cubanismo/skunk_pcb/(commit log)

2020-09-12 Check in skunkboard rev. 3 FeePCB project
    This is a direct copy of:
    FULL_RELEASE/sources/pcb3/pcb/jagwave/revision3.fpc
    renamed to skunkboard.fpc
    NOTE: Doesn't work if converted to Unix-style line
    endings!
2020-09-12 Check in skunkboard component library
    This is copied directly from:
    FULL_RELEASE/sources/pcb3/freepcb/lib_extra
2020-09-26 Rev5 checkpoint: Rerouting completed, U5+U6 placed
    -Rerouted various traces that were getting in the
    way of GPIO25 and GPIO28.
    -Clear a path to route GPIO25 and GPIO28 to the
    right edge of the board, precarious as it may be.
    -Place U5 and U6 SOIC-8 Serial EEPROM components
    -NOTE: Not connected to any nets yet.
    -Moved X1 a bit lower to make space for GPIO
    routing.
    -Tweaked J0.A54/J0.A53 trace to move its via out
    of the way of the inner-layer traces that will
    route the Serial EEPROM control lines from the
    cartridge header, as was done on Rev4.
2020-09-26 Rev5 checkpoint: Extended GND+VCC plane to right
    -Raised up bottom of GND+VCC plane on the long
    portion of the edge connector to make room for
    Serial Flash control line routes in inner layers.
    -Nudged edge of ground plane to the left at the
    ridge edge of the edge connector to make room for
    the same routes.
2020-09-26 Rev5 checkpoint: Add XSON8 footprint, add U7
    -Designed a footprint for XSON8 parts (The package
    used by the AND gate IC) based on the layouts
    recommended in the NXP document "AN10343 -
    MicroPak soldering information."
    -Placed U7 using the XSON8 footprint.
2020-09-26 Rev5 checkpoint: Routed most of Serial Flash
    All of the routing difficulties for the two Serial
    EEPROM chips have been solved now.
    -The perilous routes to the GPIO pins from the AND
    gate appear to fit!
    -The shared data and clock lines on the Serial
    EEPROM chips have been linked using vias.
    There are still some tough problems to solve.
    There is not going to be quite enough room to
    squeeze the last signals into the AND gate chip
    as-is, and routing the control lines from the
    edge connector in general is looking tricky.
2020-09-26 Rev5 checkpoint: All routing done!
    The control signals from the edge connector are
    all routed into the serial EEPROM chip and AND
    gate IC now. Only trivial tasks remain:
    -Update the silkscreen layers:
    -Add a bottom silk layer with the skunk logo and
    JTAG labels. These were very helpful during
    bringup.
    -Move version info to left side of board, update
    copyright to 2020, and don't forget to thank
    Tursi!
    -Enlarge the mini USB mounting pads to make them
    more secure.
2020-10-05 Update notes, more very minor routing tweaks
    -Leveled the Serial EEPROM trace in inner 2 layer
2020-10-05 Enlarge mini-USB/J3 mounting pads/update notes
    Similar to the Rev. 4 design, enlarge these pads
    to better anchor this heavily-used connector to
    the board.
    Also better documented the steps taken thus far to
    modify the PCB, as well as the wiring of the
    prototype on the Rev. 4 board.
2020-10-05 Finish top silkscreen layer
    -Added revision info on the left side
    -Replaced existing revision info with a thank you
    to Tursi
    -Added edge connector pin numbering on the bottom
2020-10-05 Restore 7.875mil/0.2mm trace width/clearances
    The readme.txt claims the design rule is 2mm/
    7.875mil for trace width and spacing. I had
    tweaked that to 7mil in frustration at some point,
    but it turns out it's possible to tweak a few
    things and restore the old higher requirements.
2020-10-05 Soldermask work: fix XSON8 footprint, adjust swell
    Did a bunch of research on soldermask limitations
    and what they mean for some of the fine pin-pitch
    parts used here. Basically, there's probably no
    reliable way to get soldermask between the finer
    parts. When generating some test gerber files, I
    remembered I naively set up a custom negative mask
    swell for the XSON8 footprint. I set the footprint
    to use the project default here. The project
    default was also a rather high 7.854mil (0.2mm),
    which was far more than is needed these days and
    was wiping out hte mask for the Serial EEPROM
    chip, so I lowered it to 6mil, which still removes
    all the slivers of mask between all the 0.2mm-
    spaced pads, a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
2020-10-05 First chunk of work on new logo/back silkscreen
    Figured out and documented (in skunk_v5.txt) a
    workflow for creating a gerber file from an
    Inkscape SVG file. Currently, back_silk.svg is a
    near-exact duplicate of the original back silk
    screen, but now that I've worked out the process,
    it will be trivial to make the minor updates I had
    in mind.
2020-10-05 Finish Silkscreen, update soldermask conclusions
    Made all the planned edits to the back silkscreen
    SVG file and documented the final plan for
    handling the soldermask for the fine pin pitch
    parts (manually exclude the ones with 0.2mm
    spacing, lower the soldermask pad swell to 0.3mm
    for the board overall).
    Also documented the inability of the carefully
    developed Cenon workflow to correctly convert the
    finalized back silkscreen SVG file to a gerber
    file :-(
2020-10-05 Hopefully final version of back silkscreen
    Moved the acknowledgements to the back silkscreen
    and tweaked a few things here and there.
2020-10-05 Rev. 5 PCB layout is now at RC status
    Added manual soldermask cutouts for all the parts
    with <0.3mm pad spacing and lowered the soldermask
    swell to improve coverage between pads on parts
    with spacing above that (We'll get soldermask
    between the mini USB connector pins!).
    Made a few very, very minor tweaks to a trace here
    and there.
    Removed harmlesslion.com and Tursi acknowledgement
    in favor of thanking various people on the back
    and letting the github link stand alone. I can
    always link back to harmlesslion.com or Tursi's
    skunk-related repos there.
2020-10-05 Check in Rev. 5 RC1 files
    -Added mkfab.sh, which converts the gerber files
    output by FreePCB and the crazy back silkscreen
    generation workflow into a zip file suitable for
    sending to manufacturers. It's still incomplete,
    as it should have a readme.txt packaged in there
    as well (mostly for historical benefit,
    manufacturers will likely ignore it), and OSH
    Park recommends a different file layout that
    should be supported as well via a command line
    option, but it's a start.
    -Updated pre-release checklist items based on
    initial inspection in gerber viewer
    -Checked in the RC1 manufacturing files.
2020-10-05 Updated Rev. 5 Notes: More design review completed
    Also documented a failed attempt at using FAB 3000
    to generate the bottom silkscreen layer.
2020-10-05 Finalize Rev. 5 RC1 - It's off to manufacturing!
    -Add Osh Park naming scheme support (also much
    closer to that supported by GerbView) to
    mkfab.sh. Use the '--osh' command line parameter
    to choose it.
    -Renamed thruhole.tap skunk_v5.tap in the original
    naming scheme for consistency.
    -Removed 'https://' from github URL on the front
    silkscreen. It allows the rest of the text to be
    much larger/more legible, and is really only
    necessary for very pedantic URL typers these
    days.
    -Tweaked two traces on the board that were found
    to be slightly askew during final review in
    GerbView.
    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
2020-10-13 Small cleanups to back silkscreen + release tools
    -Checked in version 5 back/bottom silkscreen
    files:
    -back_silk_v5.svg - The pre-processed silkscreen
    SVG ready for conversion.
    -back_silk_v5-fab3000.gbr - The final silkscreen
    gerber file produced using FAB 3000
    -back_silk_v5-svg2shenzen_kicad.gbr - The final
    silkscreen gerber file produced using
    svg2shenzen and KiCad.
    -Updated notes to include method to successfully
    generate a silkscreen using FAB 3000.
    -mkfab.sh: Added option to switch between
    svg2shenzen+KiCad and fab3000 bottom silkscreen
    gerber file.
    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
    [back_silk_v5-fab3000.gbr, back_silk_v5-svg2shenzen_kicad.gbr]
2020-10-13 Clean up SVG files, tweak readme.template.txt
    I forgot to save the updated skunkboard logo
    without the JTAG labels cut out of it, and when
    I went to recreate it by walking through the
    workflow I documented, I noticed there were a few
    issues with the paths (some tiny but non-zero-size
    white strokes around some letters that shouldn't
    have been there, some duplicate paths, etc.), so I
    cleaned them up further and re-generated
    back_silk.svg and back_silk_v5.svg based on the
    cleaned up versions.
    Additional changes:
    -Saved a cleaned up SVG version of the original
    logo (created from the PDF version in the
    skunkboard final release package) as
    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
2020-10-30 Rev. 5 RC2 - Move U6 to fit in standard cart case
    I realized on Rev. 4 and Rev. 5 RC1 boards that U6
    is in the way of a support structure in the Jaguar
    cartridge cases. Moving U6 over rather close to
    X1 and rerouting some traces around it (needed one
    more pair of vias) should get it *just* far enough
    out of the way to fit.
    The lowest serial EEPROM trace routed through the
    finger portion of the PCB was also raised up a bit
    to better ensure it clears the edge bevel. It
    hadn't caused any problems at the lower location
    yet, but it was cutting it closer than I'd thought
    it would. It now overlaps another trace in the
    neighboring inner layer. Hopefully this doesn't
    result in noticeable interferenc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
    [back_silk_v5-svg2shenzen_kicad.gbr]
2020-12-10 Fix svg2shenzen version of back silkscreen gerber
    For some reason, KiCad insists on putting a thing
    outline around the filled regions in its
    components, which makes its way into the gerber
    file. It's thin enough that it can either round
    down to a degenerate zero-width object or a
    1-unite-wide line, likely depending on the
    software used to view/apply the gerber file and/or
    the options set in it. I had it come back realized
    as a zero-width line in one build, and a 1-width
    line in another, both from the same manufacturer.
    To fix this, I manually removed the outlines
    entirely from the gerber file. This involved
    deleting all the pen movement commands between
    G37 and G36 sections (begin and end f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
    [back_silk_v5-svg2shenzen_kicad.gbr]
2020-12-10 back_silk_v5-svg2shenzen_kicad.gbr->DOS line ends
    Use DOS line endings in the svg2shenzen version
    of the bottom/back silk screen. This shouldn't be
    necessary as far as I can tell, but it makes it
    consistent with all the gerber files output by
    FreePCB.
    [back_silk_v5-svg2shenzen_kicad.gbr]
2020-12-10 Add KiCad-style gerber naming scheme to mkfab.sh
    Copied back over from VGA connector project
2020-12-11 Check in the final manufacturing files for Rev.5
    -Fix mkfab.sh to include the readme.txt in the zip
    file and correctly substitute the solder paste
    gerber file name.
    -Manually remove the J0 part from the solder paste
    stencil gerber file. Fixing the footprint
    correctly was causing havoc, requiring me to
    re-do a bunch of traces which then caused wrong-
    looking design check violations, so that isn't
    happening at this point. This manually edited mask
    is checked in under:
    releases/top_paste_mask_v5-J0_removed.gbr
    -Check in the final zip file, made using the
    manually edited solder paste mask gerber, the OSH/
    Protel naming conventions, and the svg2shenzen
    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
    [top_paste_mask_v5-J0_removed.gbr]
2021-02-08 Clean up footprint library files
    -Removed files duplicated from the standard
    FreePCB libraries.
    -Made sure all the non-standard parts used by the
    board are in user_created.fpl and match those
    used in skunkboard.fpc, with the exception of
    the XSON8 layout, which I added source/author/
    description data to in user_created.fpl but is
    functionally identical to the one on the PCB.
    -Add PDF file generated from latest version of
    user_created.fpl.
